Kev1n8088/OshEasyMini/OshEasyMini.kicad_pcb

## KiCad design OshEasyMini.kicad_pcb (2026-02-24)

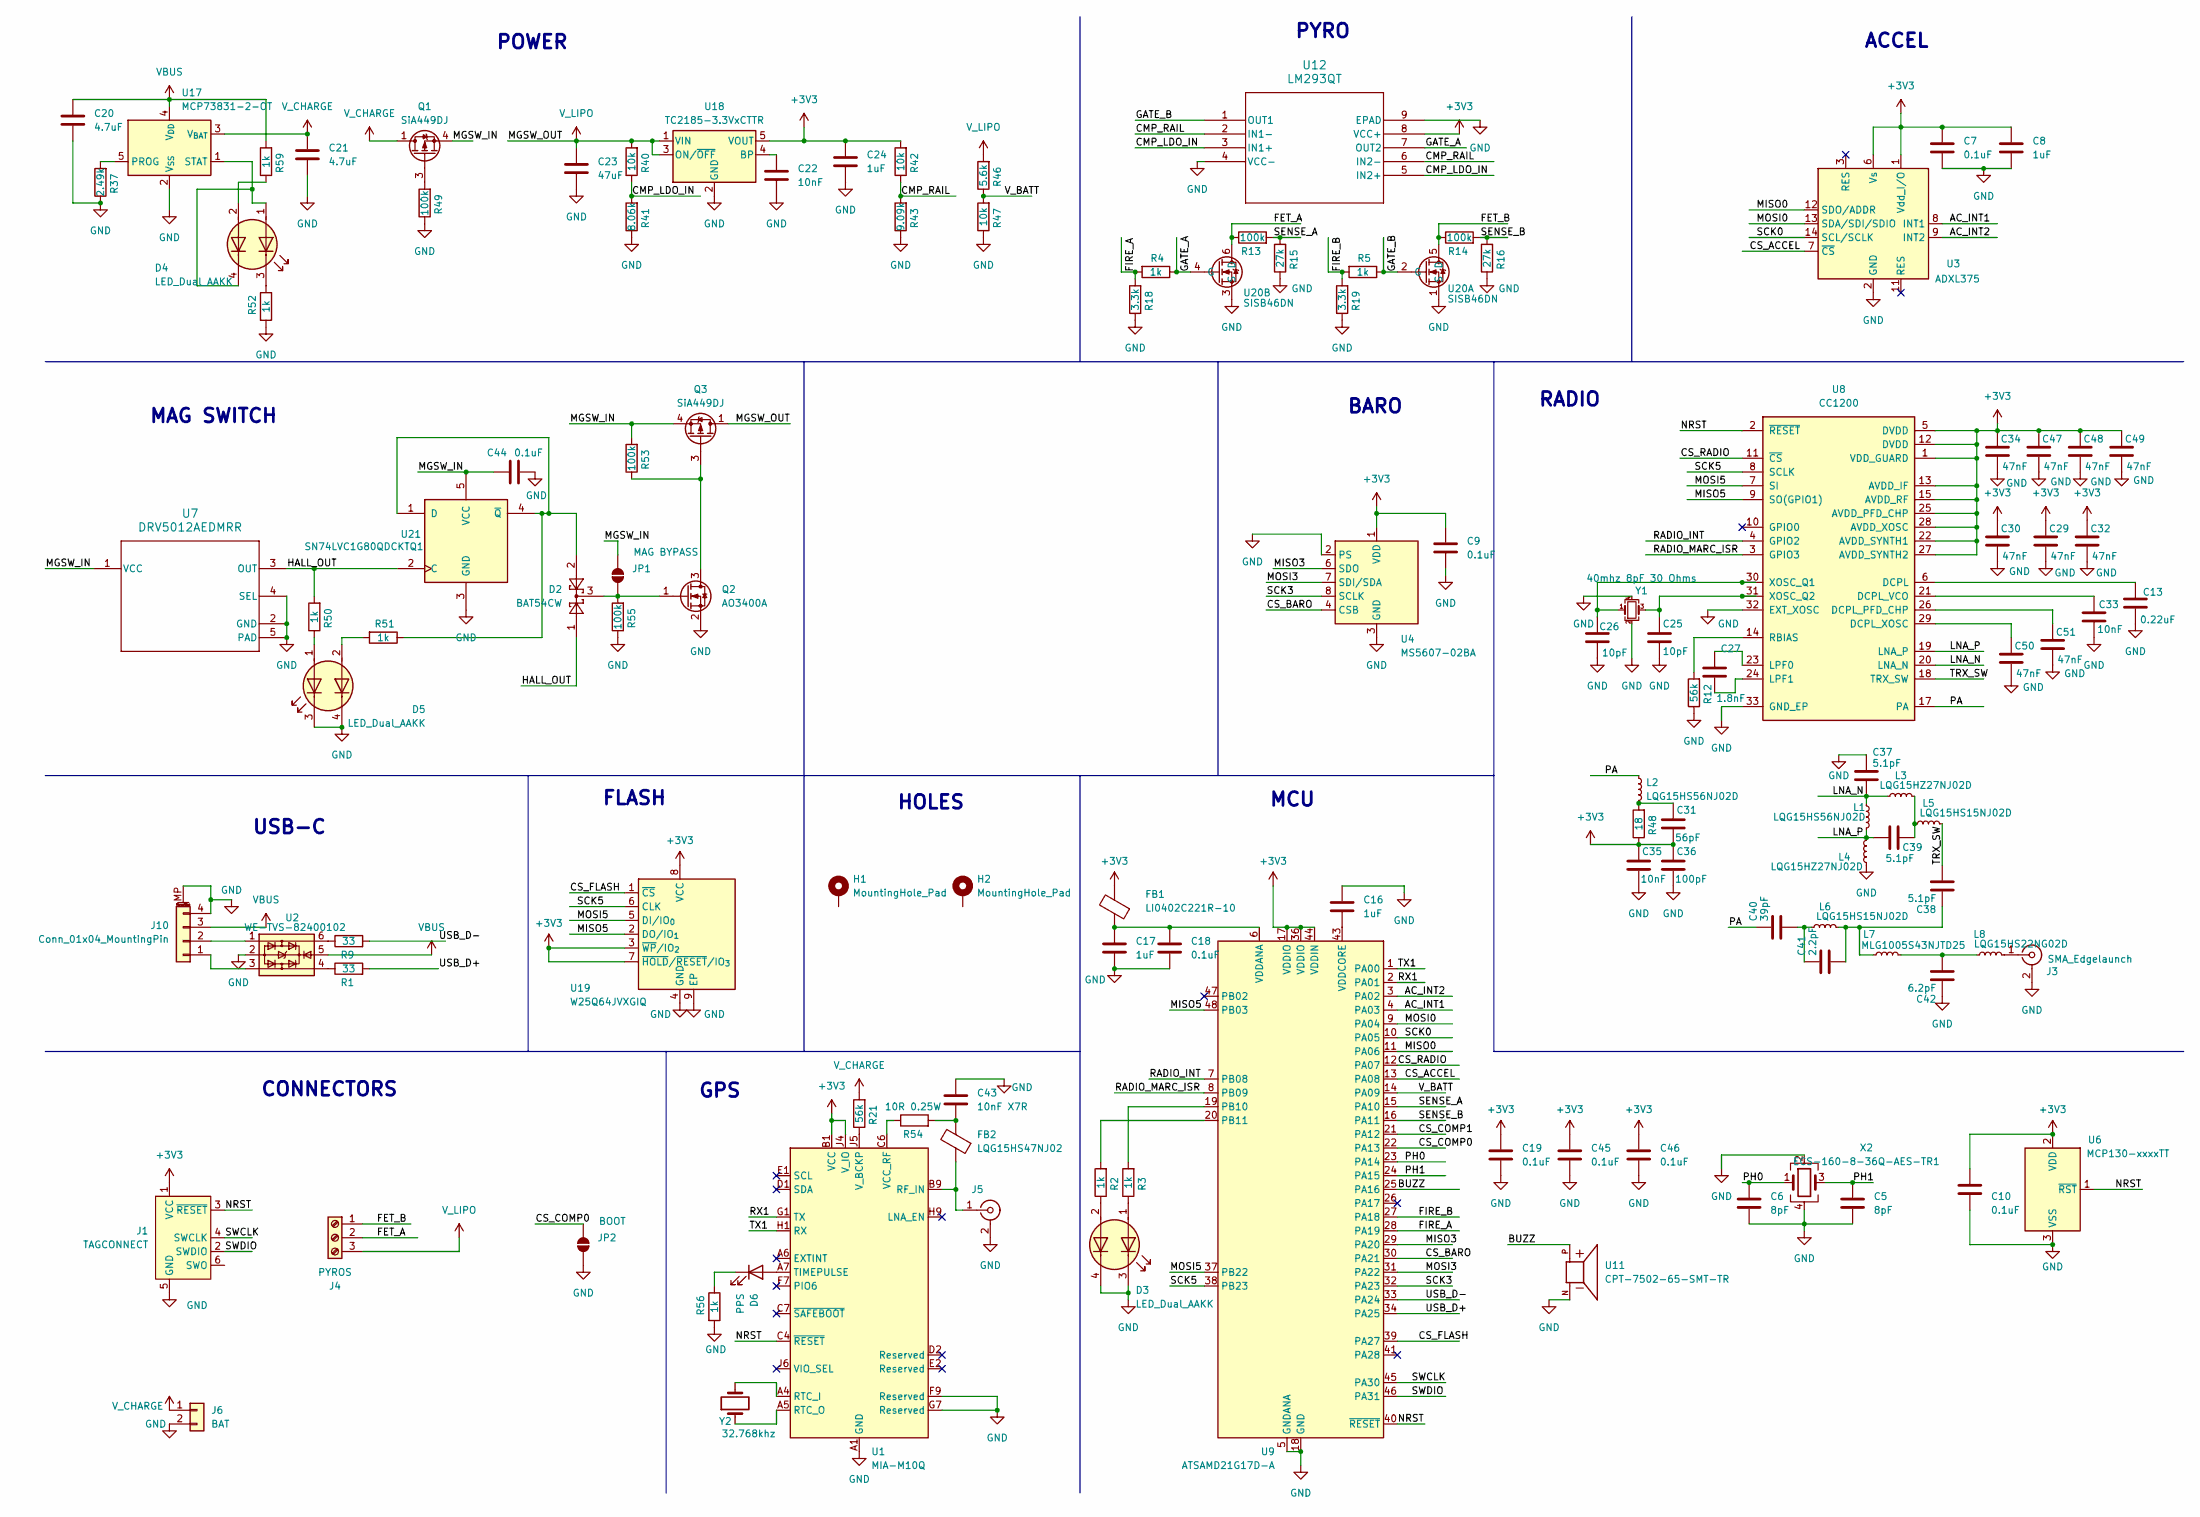
[picture p1: schematic OshEasyMini.kicad_sch, MetrumITX]

Parts:
C5, C6: 8pF; C_0402_1005Metric
C7, C9, C10, C18, C19, C44, C45, C46: 0.1uF; C_0402_1005Metric
C8, C16, C17, C24: 1uF; C_0402_1005Metric
C13: 0.22uF; C_0402_1005Metric
C20, C21: 4.7uF; C_0402_1005Metric
C22: 10nF; C_0201_0603Metric
C23: 47uF; C_1206_3216Metric
C25, C26: 10pF; C_0402_1005Metric
C27: 1.8nF; C_0402_1005Metric
C29, C30, C32, C34, C47, C48, C49, C50, C51: 47nF; C_0201_0603Metric
C31: 56pF; C_0402_1005Metric
C33, C35: 10nF; C_0402_1005Metric
C36: 100pF; C_0402_1005Metric
C37, C38, C39: 5.1pF; C_0402_1005Metric
C40: 39pF; C_0402_1005Metric
C41: 2.2pF; C_0402_1005Metric
C42: 6.2pF; C_0402_1005Metric
C43: 10nF X7R; C_0402_1005Metric
D2: BAT54CW; SOT-323_SC-70
D3, D4, D5: LED_Dual_AAKK; DualLED0606
D6: PPS; LED_0402_1005Metric
FB1: LI0402C221R-10; L_0402_1005Metric
FB2: LQG15HS47NJ02; L_0402_1005Metric
H1, H2: MountingHole_Pad; MountingHole_2.7mm_M2.5_DIN965_Pad
J1: TAGCONNECT; Tag-Connect_TC2030-IDC-NL_2x03_P1.27mm_Vertical
J3: SMA_Edgelaunch; SMA_Amphenol_132289_EdgeMount
J4: PYROS; TerminalBlock_Phoenix_MPT-0,5-3-2.54_1x03_P2.54mm_Horizontal
J5: UFL; U.FL_Molex_MCRF_73412-0110_Vertical
J6: BAT; JST_PH_B2B-PH-K_1x02_P2.00mm_Vertical
J10: Conn_01x04_MountingPin; JST_SH_BM04B-SRSS-TB_1x04-1MP_P1.00mm_Vertical
JP1: MAG BYPASS; SolderJumper-2_P1.3mm_Open_TrianglePad1.0x1.5mm
JP2: BOOT; SolderJumper-2_P1.3mm_Open_TrianglePad1.0x1.5mm
L1, L2: LQG15HS56NJ02D; L_0402_1005Metric
L3, L4: LQG15HZ27NJ02D; L_0402_1005Metric
L5, L6: LQG15HS15NJ02D; L_0402_1005Metric
L7: MLG1005S43NJTD25; L_0402_1005Metric
L8: LQG15HS22NG02D; L_0402_1005Metric
Q1, Q3: SiA449DJ; Vishay_PowerPAK_SC70-6L_Single
Q2: AO3400A; SOT-23
R1, R9: 33; R_0201_0603Metric
R2, R3, R4, R5, R50, R51, R52, R56, R59: 1k; R_0201_0603Metric
R12, R21: 56k; R_0402_1005Metric
R13, R14: 100k; R_0402_1005Metric
R15, R16: 27k; R_0402_1005Metric
R18, R19: 3.3k; R_0402_1005Metric
R37: 2.49k; R_0402_1005Metric
R40, R42, R47: 10k; R_0201_0603Metric
R41: 8.06k; R_0201_0603Metric
R43: 9.09k; R_0201_0603Metric
R46: 5.6k; R_0201_0603Metric
R48: 18; R_0402_1005Metric
R49, R53, R55: 100k; R_0201_0603Metric
R54: 10R 0.25W; R_0402_1005Metric
U1: MIA-M10Q; ublox_LGA-53_4.5x4.5mm_Layout9x9_P0.5mm
U2: WE-TVS-82400102; SOT-23-6
U3: ADXL375; LGA-14_3x5mm_P0.8mm_LayoutBorder1x6y
U4: MS5607-02BA; LGA-8_3x5mm_P1.25mm
U6: MCP130-xxxxTT; SOT-23
U7: DRV5012AEDMRR; Texas_X2SON-4-1EP_1.1x1.4mm_P0.5mm_EP0.8x0.6mm
U8: CC1200; QFN-32-1EP_5x5mm_P0.5mm_EP3.45x3.45mm
U9: ATSAMD21G17D-A; TQFP-48_7x7mm_P0.5mm
U11: CPT-7502-65-SMT-TR; XDCR_CPT-7502-65-SMT-TR; PARTREV 1.0
U12: LM293QT; DFN-8-1EP_2x2mm_P0.5mm_EP0.9x1.6mm
U17: MCP73831-2-OT; SOT-23-5
U18: TC2185-3.3VxCTTR; SOT-23-5
U19: W25Q64JVXGIQ; DFN_XGIQ TR_WIN
U20: SISB46DN; PowerPak1212-8-Dual
U21: SN74LVC1G80QDCKTQ1; SOT-353_SC-70-5
X2: ECS-160-8-36Q-AES-TR1; Crystal_SMD_2520-4Pin_2.5x2.0mm
Y1: 40mhz 8pF 30 Ohms; Crystal_SMD_Abracon_ABM10-4Pin_2.5x2.0mm
Y2: 32.768khz; Crystal_SMD_MicroCrystal_CM9V-T1A-2Pin_1.6x1.0mm

Connections:
+3V3: C7.2, C8.2, C9.2, C10.2, C19.2, C24.2, C29.2, C30.2, C31.1, C32.2, C34.2, C35.2, C36.2, C45.2, C46.2, C47.2, C48.2, C49.2, FB1.2, J1.1 (VCC), R42.2, R48.1, U1.B1 (VCC), U1.J4 (V_IO), U3.1 (Vdd_I/O), U3.6 (Vs), U4.1 (VDD), U6.2 (VDD), U8.1 (VDD_GUARD), U8.5 (DVDD), U8.12 (DVDD), U8.13 (AVDD_IF), U8.15 (AVDD_RF), U8.22 (AVDD_SYNTH1), U8.25 (AVDD_PFD_CHP), U8.27 (AVDD_SYNTH2), U8.28 (AVDD_XOSC), U9.17 (VDDIO), U9.36 (VDDIO), U9.44 (VDDIN), U12.8 (VCC+), U18.5 (VOUT), U19.3 (~WP/IO_{2}), U19.7 (~HOLD/~RESET/IO_{3}), U19.8 (VCC)
/AC_INT1: U3.8 (INT1), U9.4 (PA03)
/AC_INT2: U3.9 (INT2), U9.3 (PA02)
/BUZZ: U9.25 (PA16), U11.P
/CMP_LDO_IN: R40.1, R41.2, U12.3 (IN1+), U12.5 (IN2+)
/CMP_RAIL: R42.1, R43.2, U12.2 (IN1-), U12.6 (IN2-)
/CS_ACCEL: U3.7 (~CS), U9.13 (PA08)
/CS_BARO: U4.4 (CSB), U4.5 (CSB), U9.30 (PA21)
/CS_COMP0: JP2.2 (B), U9.22 (PA13)
/CS_COMP1: U9.21 (PA12)
/CS_FLASH: U9.39 (PA27), U19.1 (~CS)
/CS_RADIO: U8.11 (~CS), U9.12 (PA07)
/FET_A: J4.2, R13.1, U20.6 (D)
/FET_B: J4.1, R14.1, U20.5 (D)
/FIRE_A: R4.2, R18.2, U9.28 (PA19)
/FIRE_B: R5.2, R19.2, U9.27 (PA18)
/GATE_A: R4.1, U12.7 (OUT2), U20.4 (G)
/GATE_B: R5.1, U12.1 (OUT1), U20.2 (G)
/HALL_OUT: D2.1, R50.2, U7.3 (OUT), U21.2 (C)
/LNA_N: C37.1, L1.1, L3.1, U8.20 (LNA_N)
/LNA_P: C39.2, L1.2, L4.2, U8.19 (LNA_P)
/MGSW_IN: C44.2, JP1.2 (B), Q1.4 (S), Q3.4 (S), R53.2, U7.1 (VCC), U21.5 (VCC)
/MISO0: U3.12 (SDO/ADDR), U9.11 (PA06)
/MISO3: U4.6 (SDO), U9.29 (PA20)
/MISO5: U8.9 (SO(GPIO1)), U9.48 (PB03), U19.2 (DO/IO_{1})
/MOSI0: U3.13 (SDA/SDI/SDIO), U9.9 (PA04)
/MOSI3: U4.7 (SDI/SDA), U9.31 (PA22)
/MOSI5: U8.7 (SI), U9.37 (PB22), U19.5 (DI/IO_{0})
/NRST: J1.3 (~RESET), U1.C4 (~RESET), U6.1 (~RST), U8.2 (~RESET), U9.40 (~RESET)
/PA: C40.2, L2.1, U8.17 (PA)
/PH0: C6.2, U9.23 (PA14), X2.1
/PH1: C5.2, U9.24 (PA15), X2.3
/RADIO_INT: U8.4 (GPIO2), U9.7 (PB08)
/RADIO_MARC_ISR: U8.3 (GPIO3), U9.8 (PB09)
/RX1: U1.G1 (TX), U9.2 (PA01)
/SCK0: U3.14 (SCL/SCLK), U9.10 (PA05)
/SCK3: U4.8 (SCLK), U9.32 (PA23)
/SCK5: U8.8 (SCLK), U9.38 (PB23), U19.6 (CLK)
/SENSE_A: R13.2, R15.2, U9.15 (PA10)
/SENSE_B: R14.2, R16.2, U9.16 (PA11)
/SWCLK: J1.4 (SWCLK), U9.45 (PA30)
/SWDIO: J1.2 (SWDIO), U9.46 (PA31)
/TRX_SW: C38.1, L5.2, U8.18 (TRX_SW)
/TX1: U1.H1 (RX), U9.1 (PA00)
/USB_D+: R1.2, U9.34 (PA25)
/USB_D-: R9.2, U9.33 (PA24)
/V_BATT: R46.1, R47.2, U9.14 (PA09)
GND: C5.1, C6.1, C7.1, C8.1, C9.1, C10.1, C13.1, C16.2, C17.1, C18.1, C19.1, C20.1, C21.1, C22.1, C23.1, C24.1, C25.1, C26.1, C29.1, C30.1, C32.1, C33.1, C34.1, C35.1, C36.1, C37.2, C42.2, C43.2, C44.1, C45.1, C46.1, C47.1, C48.1, C49.1, C50.1, C51.1, D3.3 (K1), D3.4 (K2), D5.3 (K1), D5.4 (K2), J1.5 (GND), J3.2 (Ext), J5.2 (Ext), J6.2, J10.4, J10.MP (MountPin), JP2.1 (A), L4.1, Q2.2 (S), R12.1, R15.1, R16.1, R18.1, R19.1, R37.1, R41.1, R43.1, R47.1, R49.1, R52.2, R55.1, R56.2, U1.A1 (GND), U1.A2 (GND), U1.A3 (GND), U1.A8 (GND), U1.A9 (GND), U1.B2 (GND), U1.B8 (GND), U1.C3 (GND), U1.C9 (GND), U1.E3 (GND), U1.E4 (GND), U1.E9 (GND), U1.F1 (GND), U1.F3 (GND), U1.F4 (GND), U1.F9 (Reserved), U1.G3 (GND), U1.G4 (GND), U1.G5 (GND), U1.G6 (GND), U1.G7 (Reserved), U1.H8 (GND), U1.J8 (GND), U1.J9 (GND), U2.2, U3.2 (GND), U3.4 (GND), U3.5 (GND), U4.2 (PS), U4.3 (GND), U6.3 (VSS), U7.2 (GND), U7.4 (SEL), U7.5 (PAD), U8.32 (EXT_XOSC), U8.33 (GND_EP), U9.5 (GNDANA), U9.18 (GND), U9.35 (GND), U9.42 (GND), U11.N, U12.4 (VCC-), U12.9 (EPAD), U17.2 (V_{SS}), U18.2 (GND), U19.4 (GND), U19.9 (EP), U20.1 (S), U20.3 (S), U21.3 (GND), X2.2, X2.4, Y1.2, Y1.4; also elsewhere on the board
unnamed: C31.2, L2.2, R48.2
unnamed: C38.2, C41.1, L6.2, L7.1
unnamed: C39.1, L3.2, L5.1
unnamed: C40.1, C41.2, L6.1
unnamed: C42.1, L7.2, L8.1
unnamed: C43.1, FB2.2, R54.2
unnamed: D3.1 (A1), R3.1
unnamed: D3.2 (A2), R2.1
unnamed: D4.1 (A1), D4.4 (K2), U17.1 (STAT)
unnamed: D4.2 (A2), R59.1
unnamed: D4.3 (K1), R52.1
unnamed: D5.1 (A1), R50.1
unnamed: D5.2 (A2), R51.2
unnamed: D6.2 (A), U1.A7 (TIMEPULSE)
unnamed: D6.1 (K), R56.1
unnamed: J3.1 (In), L8.2
unnamed: FB2.1, J5.1 (In), U1.B9 (RF_IN)
unnamed: J10.1, U2.3
unnamed: J10.2, U2.1
unnamed: D2.3, JP1.1 (A), Q2.1 (G), R55.2
unnamed: Q1.3 (G), R49.2
unnamed: Q2.3 (D), Q3.3 (G), R53.1
unnamed: R1.1, U2.4
unnamed: R9.1, U2.6
unnamed: U1.A4 (RTC_I), Y2.2
unnamed: U1.A5 (RTC_O), Y2.1
unnamed: R54.1, U1.C6 (VCC_RF)
unnamed: R21.1, U1.J5 (V_BCKP)
unnamed: C13.2, U8.6 (DCPL)
unnamed: C51.2, U8.26 (DCPL_PFD_CHP)
unnamed: C33.2, U8.21 (DCPL_VCO)
unnamed: C50.2, U8.29 (DCPL_XOSC)
unnamed: C27.2, U8.23 (LPF0)
unnamed: C27.1, U8.24 (LPF1)
unnamed: R12.2, U8.14 (RBIAS)
unnamed: C26.2, U8.30 (XOSC_Q1), Y1.1
unnamed: C25.2, U8.31 (XOSC_Q2), Y1.3
unnamed: R3.2, U9.19 (PB10)
unnamed: R2.2, U9.20 (PB11)
unnamed: C17.2, C18.2, FB1.1, U9.6 (VDDANA)
unnamed: C16.1, U9.43 (VDDCORE)
unnamed: R37.2, U17.5 (PROG)
unnamed: C22.2, U18.4 (BP)
unnamed: D2.2, R51.1, U21.1 (D), U21.4 (~Q)
VBUS: C20.2, J10.3, R59.2, U2.5, U17.4 (V_{DD})
V_CHARGE: C21.2, J6.1, Q1.1 (D), R21.2, U17.3 (V_{BAT})
V_LIPO: C23.2, J4.3, Q3.1 (D), R40.2, R46.2, U18.1 (VIN), U18.3 (ON/~OFF)

Notes on the sheet:
FLASH
PYRO
MCU
USB-C
ACCEL
RADIO
BARO
CONNECTORS
GPS
MAG SWITCH
POWER
HOLES

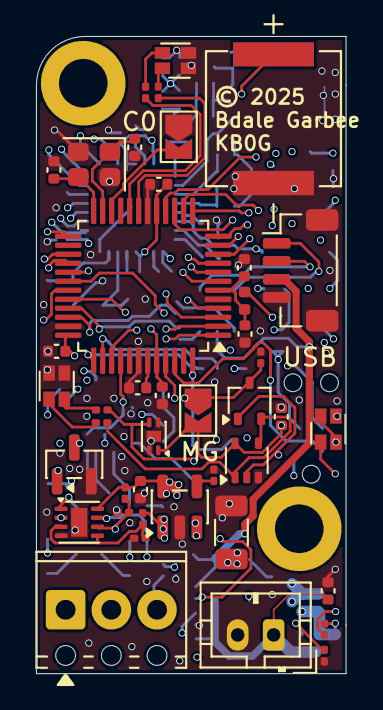
[picture p2: board OshEasyMini.kicad_pcb from above]

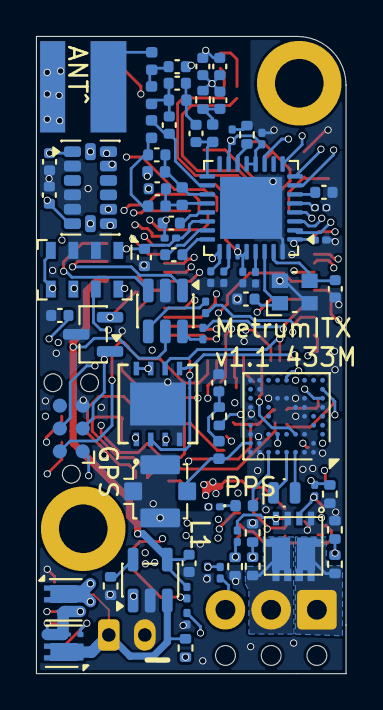
[picture p3: board OshEasyMini.kicad_pcb from below]

Board: 6 copper layers, 17.2 x 35.4 mm, 120 parts (76 on the bottom side), 94 nets.

Other parts of the board:
J3#2: SMA_Edgelaunch; SMA_Amphenol_132289_EdgeMount

Their connections:
GND: J3#2.1 (In); also elsewhere on the board
