Kev1n8088/OshEasyMini/USBCAdapter/USBCAdapter.kicad_pcb

## KiCad design USBCAdapter/USBCAdapter.kicad_pcb (2025-12-20)

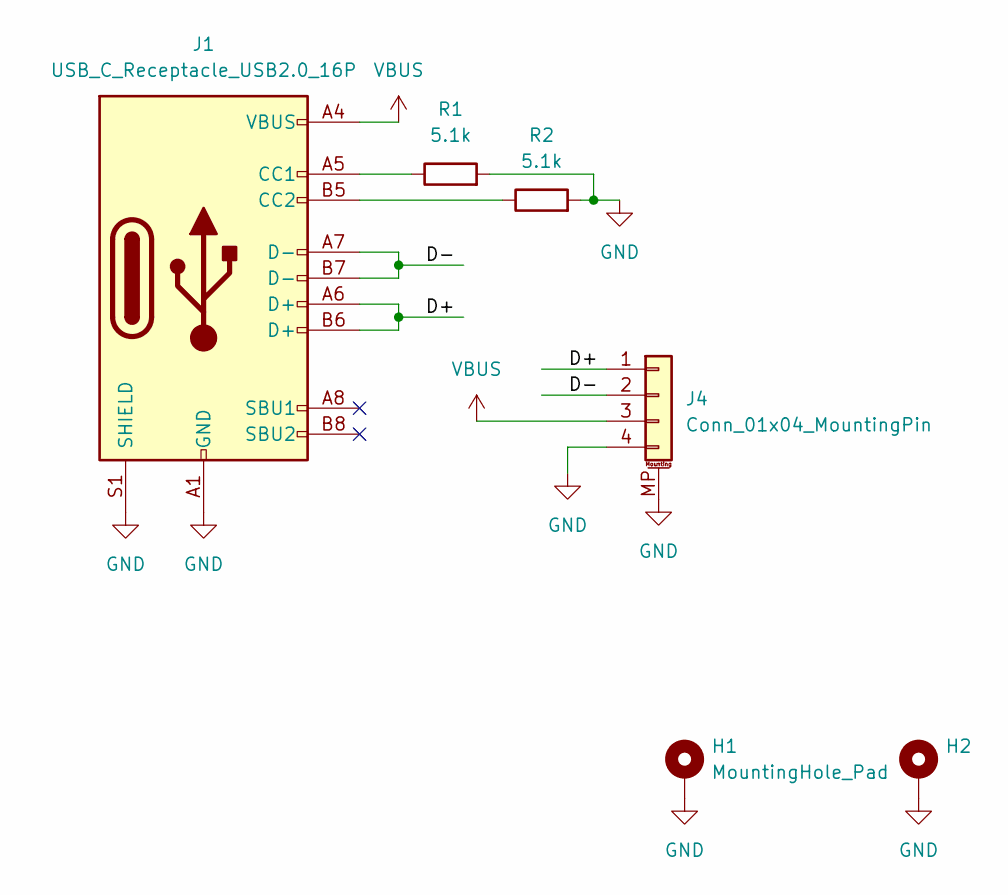
[picture p4: schematic USBCAdapter.kicad_sch]

Parts:
H1, H2: MountingHole_Pad; MountingHole_2.7mm_M2.5_DIN965_Pad
J1: USB_C_Receptacle_USB2.0_16P; USB_C_Receptacle_G-Switch_GT-USB-7010ASV
J4: Conn_01x04_MountingPin; JST_SH_SM04B-SRSS-TB_1x04-1MP_P1.00mm_Horizontal
R1, R2: 5.1k; R_0402_1005Metric

Connections:
/D+: J1.A6 (D+), J1.B6 (D+), J4.1
/D-: J1.A7 (D-), J1.B7 (D-), J4.2
GND: H1.1, H2.1, J1.A1 (GND), J1.A12 (GND), J1.B1 (GND), J1.B12 (GND), J1.S1 (SHIELD), J4.4, J4.MP (MountPin), R1.2, R2.2
unnamed: J1.A5 (CC1), R1.1
unnamed: J1.B5 (CC2), R2.1
VBUS: J1.A4 (VBUS), J1.A9 (VBUS), J1.B4 (VBUS), J1.B9 (VBUS), J4.3

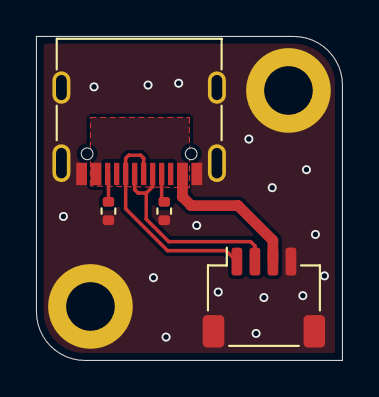
[picture p5: board USBCAdapter.kicad_pcb from above]

Board: 2 copper layers, 17.0 x 18.0 mm, 6 parts (0 on the bottom side), 6 nets.
