Kev1n8088/OshEasyMini/(commit log)

2025-11-18 good progress, changed to mia-m10
    [OshEasyMini.kicad_pcb, OshEasyMini.kicad_sch]
2025-11-18 all components placed currently routing
    [OshEasyMini.kicad_pcb, OshEasyMini.kicad_sch]
2025-11-19 routing done, need to remove SAW and impedance match
    [BOM-OshEasyMini.csv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]
2025-11-19 finished usbc daughterboard, next removing charging circuitry onboard
    [OshEasyMini.kicad_pcb, OshEasyMini.kicad_sch, USBCAdapter.kicad_pcb, USBCAdapter.kicad_sch]
2025-11-19 switched back to onboard charger and the most boring adapter board ever
    [USBCAdapter.kicad_pcb, USBCAdapter.kicad_sch]
2025-12-20 ready for final prod after silkscreens
    [BOM-OshEasyMini.csv, BOM-USBCAdapter.csv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]
2025-12-20 added silks
    [OshEasyMini.kicad_pcb]
2026-02-11 v1 sent for build
    [BOM-OshEasyMini.csv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]
2026-02-11 v1.1 revision with capacitor moved to ease in assembly, and added copyright per TAPR
    [OshEasyMini.kicad_pcb, OshEasyMini.kicad_sch]
2026-02-20 CRITICAL: GPS UART RX/TX swapped. Fixed.
    [CPL-OshEasyMini.csv, OshEasyMini-CuBottom.gbr, OshEasyMini-CuIn1.gbr, OshEasyMini-CuIn2.gbr, OshEasyMini-CuIn3.gbr, OshEasyMini-CuIn4.gbr, OshEasyMini-CuTop.gbr, OshEasyMini-EdgeCuts.gbr]
2026-02-24 fixed gnd pad for antenna. Also investigating rf frontend capacitor types
    [OshEasyMini.kicad_pcb]
