Kev1n8088/OshEasyMini/(notices)

Notices in the files:
OshEasyMini.kicad_sch:
Copyright 2025 by Bdale Garbee
OshEasyMini.kicad_pcb:
© 2025
